hgeisse/eco32/hwtests/serial/fpga2pc/README

1. Write one of 'send0' or 'send1' to the on-board Flash ROM.
2. Load ECO32 into the FPGA.
3. While holding ECO32 in reset, start 'receive' on the PC. Choose the
   serial port according to the serial line the board is sending on.
4. Release the reset button. After a while 'receive' shows a report.
