hgeisse/eco32/libtest/abi/README

1. Register Usage
-----------------

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

caller-save registers are not preserved across procedure calls
callee-save registers are preserved across procedure calls

2. Data Type Storage Layout, Alignment, Padding
-----------------------------------------------

char         : 1 byte, no restrictions
short        : 2 bytes, aligned on 2-byte boundary
int          : 4 bytes, aligned on 4-byte boundary
long         : 4 bytes, aligned on 4-byte boundary
long long    : 4 bytes, aligned on 4-byte boundary
float        : 4 bytes, aligned on 4-byte boundary
double       : 4 bytes, aligned on 4-byte boundary
long double  : 4 bytes, aligned on 4-byte boundary
Type *       : 4 bytes, aligned on 4-byte boundary
struct       : as many bytes as needed,
               aligned for most restrictive component

3. Stack Frame Layout, Calling Conventions
------------------------------------------
