hgeisse/eco32/doc/manual/eco32.tex

\documentclass{amsbook}
\usepackage[english]{babel}
\usepackage{graphicx}
\usepackage[pdfborder={0,0,0},colorlinks=true,linkcolor=blue,urlcolor=red]{hyperref}
\begin{document}
\title{ECO32 User Manual}
\author{Martin Geisse}
\maketitle

\newcommand{\mylabel}[1]{\label{#1}}
\newcommand{\myref}[2]{\hyperref[#2]{Chapter #1, Section \ref{#2}}}

\newcommand{\definition}[1]{{\it #1}}
\newcommand{\name}[1]{{\it #1}}

\newcommand{\eco}{{\sc ECO32} }
\newcommand{\ecox}{{\sc ECO32}}
\newcommand{\pc}{{\sc PC} }
\newcommand{\pcx}{{\sc PC}}
\newcommand{\psw}{{\sc PSW} }
\newcommand{\pswx}{{\sc PSW}}
\newcommand{\mmu}{{\sc MMU} }
\newcommand{\mmux}{{\sc MMU}}

\tableofcontents
\input{intro}
\input{architecture}
\input{isa/isa}
\input{signals}
\input{demosoc}
\input{ownsoc}
\input{toolchain}
\input{impl}
\input{mybib}

\end{document}
