hgeisse/eco32/fpga/experiments/de2-115/pipectrl/README

This experiment explores a very simple 5-stage
pipeline together with its control signals.
