hgeisse/eco32/fpga/experiments/de2-115/memdelay/README

This circuit implements a RAM simulation with adjustable
read/write delays. The test FSM allows verifying both
access times.
