hgeisse/eco32/fpga/tests/test_101/README

Note: This test may run for a long time (e.g., 50 minutes) and it
may produce a large dump file (e.g., 12 GB).
