hgeisse/eco32/fpga/experiments/sim/dac/README

Timing Parameters
-----------------

clk = 50 MHz (20 nsec)
mclk = clk / 4 = 12.5 MHz (80 nsec)
bclk = mclk / 4 = 3.125 MHz (320 nsec)
lrck = bclk / 64 = 48.828 kHz (20.48 usec)

==>

fs = 48.828 kHz
mclk = 256 * fs = 12.5 MHz
bclk = 64 * fs = 3.125 MHz
