hgeisse/eco32/fpga/experiments/de2-115/memctrl-128/README

Here you can find SDRAM memory controllers
with a 128-bit host interface.
