hgeisse/eco32/fpga/experiments/de2-115/memctrl-32/README

Here you can find SDRAM memory controllers
with a 32-bit host interface.
