hgeisse/eco32/fpga/experiments/xsa-xst-3/memctrl-64/README

Here you can find SDRAM memory controllers
with a 64-bit host interface.
