hgeisse/eco32/fpga/mc/src/sdc/sdc.v

//
// sdc.v -- SD card interface
//


`timescale 1ns/10ps
`default_nettype none


//
// These constants define the two SCLK frequencies:
// f = 25 MHz / (n + 1)
//
`define FAST_WAIT	6'd0
`define SLOW_WAIT	6'd63


module sdc(clk, rst,
           stb, we, addr,
           data_in, data_out,
           ack,
           ss_n, sclk,
           mosi, miso,
           wp);
    // internal interface
    input clk;
    input rst;
    input stb;
    input we;
    input [3:2] addr;
    input [31:0] data_in;
    output [31:0] data_out;
    output ack;
    // external interface
    output reg ss_n;
    output reg sclk;
    output mosi;
    input miso;
    input wp;

  reg [8:0] sreg;
  wire load;
  wire shift;
  wire latch;
  wire ready;

  reg [4:0] state;
  reg [5:0] wtcnt;
  wire [5:0] wtnum;

  reg crc16_miso;
  reg fast_clock;
  reg rdy;

  wire crc7_in;
  reg [7:0] crc7;
  wire crc16_in;
  reg [15:0] crc16;

  always @(posedge clk) begin
    if (rst) begin
      sreg[8:0] <= 9'h1FF;
    end else begin
      if (load) begin
        sreg[8:1] <= data_in[7:0];
      end else begin
        if (shift) begin
          sreg[8:1] <= sreg[7:0];
        end
        if (latch) begin
          sreg[0] <= miso;
        end
      end
    end
  end

  assign mosi = sreg[8];

  assign wtnum[5:0] = fast_clock ? `FAST_WAIT : `SLOW_WAIT;

  always @(posedge clk) begin
    if (rst) begin
      sclk  <= 0;
      wtcnt[5:0] <= 6'd0;
      state[4:0] <= 5'd0;
    end else begin
      if (| wtcnt[5:0]) begin
        wtcnt[5:0] <= wtcnt[5:0] - 6'd1;
      end else begin
        case (state[4:0])
          5'd0:
            begin
              if (~load) begin
                state <= 5'd0;
              end else begin
                state <= 5'd1;
                wtcnt <= wtnum;
              end
            end
          5'd1:
            begin
              sclk  <= 1;
              state <= 5'd2;
              wtcnt <= wtnum;
            end
          5'd2:
            begin
              sclk  <= 0;
              state <= 5'd3;
              wtcnt <= wtnum;
            end
          5'd3:
            begin
              sclk  <= 1;
              state <= 5'd4;
              wtcnt <= wtnum;
            end
          5'd4:
            begin
              sclk  <= 0;
              state <= 5'd5;
              wtcnt <= wtnum;
            end
          5'd5:
            begin
              sclk  <= 1;
              state <= 5'd6;
              wtcnt <= wtnum;
            end
          5'd6:
            begin
              sclk  <= 0;
              state <= 5'd7;
              wtcnt <= wtnum;
            end
          5'd7:
            begin
              sclk  <= 1;
              state <= 5'd8;
              wtcnt <= wtnum;
            end
          5'd8:
            begin
              sclk  <= 0;
              state <= 5'd9;
              wtcnt <= wtnum;
            end
          5'd9:
            begin
              sclk  <= 1;
              state <= 5'd10;
              wtcnt <= wtnum;
            end
          5'd10:
            begin
              sclk  <= 0;
              state <= 5'd11;
              wtcnt <= wtnum;
            end
          5'd11:
            begin
              sclk  <= 1;
              state <= 5'd12;
              wtcnt <= wtnum;
            end
          5'd12:
            begin
              sclk  <= 0;
              state <= 5'd13;
              wtcnt <= wtnum;
            end
          5'd13:
            begin
              sclk  <= 1;
              state <= 5'd14;
              wtcnt <= wtnum;
            end
          5'd14:
            begin
              sclk  <= 0;
              state <= 5'd15;
              wtcnt <= wtnum;
            end
          5'd15:
            begin
              sclk  <= 1;
              state <= 5'd16;
              wtcnt <= wtnum;
            end
          5'd16:
            begin
              sclk  <= 0;
              state <= 5'd17;
              wtcnt <= wtnum;
            end
          5'd17:
            begin
              sclk  <= 0;
              state <= 5'd0;
              wtcnt <= 0;
            end
          default:
            begin
              sclk  <= 0;
              state <= 5'd0;
              wtcnt <= wtnum;
            end
        endcase
      end
    end
  end

  assign load = stb & we & ~addr[3] & addr[2];
  assign shift =
    (state ==  2 || state ==  4 ||
     state ==  6 || state ==  8 ||
     state == 10 || state == 12 ||
     state == 14 || state == 16) &&
    (wtcnt == 0);
  assign latch =
    (state ==  1 || state ==  3 ||
     state ==  5 || state ==  7 ||
     state ==  9 || state == 11 ||
     state == 13 || state == 15) &&
    (wtcnt == 0);
  assign ready = (state == 17) && (wtcnt == 0);

  always @(posedge clk) begin
    if (rst) begin
      crc16_miso <= 0;
      fast_clock <= 0;
      ss_n <= 1;
    end else begin
      if (stb & we & ~addr[3] & ~addr[2]) begin
        crc16_miso <= data_in[2];
        fast_clock <= data_in[1];
        ss_n <= ~data_in[0];
      end
    end
  end

  always @(posedge clk) begin
    if (rst) begin
      rdy <= 0;
    end else begin
      if (ready | (stb & ~we & ~addr[3] & addr[2])) begin
        rdy <= ready;
      end
    end
  end

  assign data_out[31:0] =
    (~addr[3] & ~addr[2]) ? { 30'h0, wp, rdy } :
    (~addr[3] &  addr[2]) ? { 24'h0, sreg[8:1] } :
    ( addr[3] & ~addr[2]) ? { 24'h0, crc7[7:0] } :
                            { 16'h0, crc16[15:0] };
  assign ack = stb;

  assign crc7_in = mosi;

  always @(posedge clk) begin
    if (rst) begin
      crc7[7:0] <= 8'h0;
    end else begin
      if (stb & we & addr[3] & ~addr[2]) begin
        crc7[7:0] <= data_in[7:0];
      end else begin
        if (latch) begin
          crc7[7] <= crc7[6];
          crc7[6] <= crc7[5];
          crc7[5] <= crc7[4];
          crc7[4] <= crc7[3] ^ crc7[7] ^ crc7_in;
          crc7[3] <= crc7[2];
          crc7[2] <= crc7[1];
          crc7[1] <= crc7[7] ^ crc7_in;
        end
      end
    end
  end

  assign crc16_in = crc16_miso ? miso : mosi;

  always @(posedge clk) begin
    if (rst) begin
      crc16[15:0] <= 16'h0;
    end else begin
      if (stb & we & addr[3] & addr[2]) begin
        crc16[15:0] <= data_in[15:0];
      end else begin
        if (latch) begin
          crc16[15] <= crc16[14];
          crc16[14] <= crc16[13];
          crc16[13] <= crc16[12];
          crc16[12] <= crc16[11] ^ crc16[15] ^ crc16_in;
          crc16[11] <= crc16[10];
          crc16[10] <= crc16[ 9];
          crc16[ 9] <= crc16[ 8];
          crc16[ 8] <= crc16[ 7];
          crc16[ 7] <= crc16[ 6];
          crc16[ 6] <= crc16[ 5];
          crc16[ 5] <= crc16[ 4] ^ crc16[15] ^ crc16_in;
          crc16[ 4] <= crc16[ 3];
          crc16[ 3] <= crc16[ 2];
          crc16[ 2] <= crc16[ 1];
          crc16[ 1] <= crc16[ 0];
          crc16[ 0] <= crc16[15] ^ crc16_in;
        end
      end
    end
  end

endmodule
