hgeisse/eco32/fpga/mc/src/kbd/kbd.v

//
// kbd.v -- PS/2 keyboard interface
//


`timescale 1ns/10ps
`default_nettype none


module kbd(clk, rst,
           stb, we, addr,
           data_in, data_out,
           ack, irq,
           ps2_clk, ps2_data);
    // internal interface
    input clk;
    input rst;
    input stb;
    input we;
    input addr;
    input [7:0] data_in;
    output [7:0] data_out;
    output ack;
    output irq;
    // external interface
    input ps2_clk;
    input ps2_data;

  wire [7:0] keyboard_data;
  wire keyboard_rdy;
  reg [7:0] data;
  reg rdy;
  reg ien;

  keyboard keyboard_1(
    .ps2_clk(ps2_clk),
    .ps2_data(ps2_data),
    .clk(clk),
    .rst(rst),
    .keyboard_data(keyboard_data[7:0]),
    .keyboard_rdy(keyboard_rdy)
  );

  always @(posedge clk) begin
    if (rst) begin
      data[7:0] <= 8'h00;
      rdy <= 1'b0;
      ien <= 1'b0;
    end else begin
      if (keyboard_rdy) begin
        data[7:0] <= keyboard_data[7:0];
      end
      if (keyboard_rdy | (stb & ~we & addr)) begin
        rdy <= keyboard_rdy;
      end
      if (stb & we & ~addr) begin
        ien <= data_in[1];
      end
    end
  end

  assign data_out[7:0] = ~addr ? { 6'h00, ien, rdy } : data[7:0];
  assign ack = stb;
  assign irq = ien & rdy;

endmodule
