hgeisse/eco32/fpga/pl-sim/eco32test.cfg

[*]
[*] GTKWave Analyzer v3.3.86 (w)1999-2017 BSI
[*] Thu Nov 29 08:52:59 2018
[*]
[dumpfile] "/home/hellwig/GitHub/eco32/fpga/pl-sim/dump.vcd"
[dumpfile_mtime] "Thu Nov 29 08:51:08 2018"
[dumpfile_size] 3534568
[savefile] "/home/hellwig/GitHub/eco32/fpga/pl-sim/eco32test.cfg"
[timestart] 0
[size] 1213 745
[pos] -1 -1
*-15.000000 -1 -1 -1 -1 -1 -1 -1 -1 -1 -1 -1 -1 -1 -1 -1 -1 -1 -1 -1 -1 -1 -1 -1 -1 -1 -1 -1
[treeopen] eco32test.
[treeopen] eco32test.eco32_1.
[treeopen] eco32test.eco32_1.cpu_1.
[treeopen] eco32test.eco32_1.cpu_1.if2_1.
[treeopen] eco32test.eco32_1.ramctrl_1.
[treeopen] eco32test.eco32_1.romctrl_1.
[sst_width] 223
[signals_width] 206
[sst_expanded] 1
[sst_vpaned_height] 321
@200
----   CLK_RST   ---
@28
eco32test.eco32_1.clk
eco32test.eco32_1.rst
@200
----     CPU     ---
-IF1a
@28
eco32test.eco32_1.cpu_1.if1a_1.if1a_ready_in
@22
eco32test.eco32_1.cpu_1.if1a_1.holdoff[7:0]
@28
eco32test.eco32_1.cpu_1.if1a_1.holdoff_counting
@22
eco32test.eco32_1.cpu_1.if1a_1.distance[3:0]
@28
eco32test.eco32_1.cpu_1.if1a_1.distance_restart
eco32test.eco32_1.cpu_1.if1a_1.if1a_valid_out
@22
eco32test.eco32_1.cpu_1.if1a_1.if1a_counter_out[9:0]
@200
-IF1b
@28
eco32test.eco32_1.cpu_1.if1b_1.if1b_ready_out
eco32test.eco32_1.cpu_1.if1b_1.if1b_valid_in
@22
eco32test.eco32_1.cpu_1.if1b_1.if1b_counter_in[9:0]
@28
eco32test.eco32_1.cpu_1.if1b_1.if1b_ready_in
eco32test.eco32_1.cpu_1.if1b_1.if1b_valid_out
@22
eco32test.eco32_1.cpu_1.if1b_1.if1b_vaddr_out[31:0]
@200
-IF2
@28
eco32test.eco32_1.cpu_1.if2_1.if2_ready_out
eco32test.eco32_1.cpu_1.if2_1.if2_valid_in
@22
eco32test.eco32_1.cpu_1.if2_1.if2_vaddr_in[31:0]
eco32test.eco32_1.cpu_1.if2_1.page[19:0]
eco32test.eco32_1.cpu_1.if2_1.offset[11:0]
eco32test.eco32_1.cpu_1.if2_1.page_buf[19:0]
eco32test.eco32_1.cpu_1.if2_1.offset_buf[11:0]
@200
----
@22
eco32test.eco32_1.cpu_1.if2_1.tlb_1.page_in[19:0]
@28
eco32test.eco32_1.cpu_1.if2_1.tlb_1.miss
@22
eco32test.eco32_1.cpu_1.if2_1.tlb_1.found[4:0]
eco32test.eco32_1.cpu_1.if2_1.tlb_1.frame_out[19:0]
@200
----
@22
eco32test.eco32_1.cpu_1.if2_1.mapped_frame[17:0]
eco32test.eco32_1.cpu_1.if2_1.direct_frame[17:0]
eco32test.eco32_1.cpu_1.if2_1.frame[17:0]
@28
eco32test.eco32_1.cpu_1.if2_1.if2_ready_in
eco32test.eco32_1.cpu_1.if2_1.if2_valid_out
@22
eco32test.eco32_1.cpu_1.if2_1.if2_paddr_out[29:0]
@200
-IF3
@28
eco32test.eco32_1.cpu_1.if3_1.if3_ready_in
eco32test.eco32_1.cpu_1.if3_1.if3_ready_out
eco32test.eco32_1.cpu_1.if3_1.if3_valid_in
eco32test.eco32_1.cpu_1.if3_1.valid_buf
eco32test.eco32_1.cpu_1.if3_1.if3_valid_out
@22
eco32test.eco32_1.cpu_1.if3_1.if3_paddr_in[29:0]
eco32test.eco32_1.cpu_1.if3_1.tag[16:0]
eco32test.eco32_1.cpu_1.if3_1.index[8:0]
@28
eco32test.eco32_1.cpu_1.if3_1.offset[1:0]
@22
eco32test.eco32_1.cpu_1.if3_1.tag_buf[16:0]
eco32test.eco32_1.cpu_1.if3_1.index_buf[8:0]
@28
eco32test.eco32_1.cpu_1.if3_1.offset_buf[1:0]
eco32test.eco32_1.cpu_1.if3_1.sel_index[1:0]
@22
eco32test.eco32_1.cpu_1.if3_1.cur_index[8:0]
@28
eco32test.eco32_1.cpu_1.if3_1.line_0_valid_out
@22
eco32test.eco32_1.cpu_1.if3_1.line_0_tag_out[16:0]
eco32test.eco32_1.cpu_1.if3_1.line_0_data_out[127:0]
@28
eco32test.eco32_1.cpu_1.if3_1.line_0_hit
eco32test.eco32_1.cpu_1.if3_1.line_1_valid_out
@22
eco32test.eco32_1.cpu_1.if3_1.line_1_tag_out[16:0]
eco32test.eco32_1.cpu_1.if3_1.line_1_data_out[127:0]
@28
eco32test.eco32_1.cpu_1.if3_1.line_1_hit
@22
eco32test.eco32_1.cpu_1.if3_1.line_data_out[127:0]
eco32test.eco32_1.cpu_1.if3_1.if3_inst_out[31:0]
@28
eco32test.eco32_1.cpu_1.if3_1.hit
eco32test.eco32_1.cpu_1.if3_1.lru_out
eco32test.eco32_1.cpu_1.if3_1.memory_ack
eco32test.eco32_1.cpu_1.if3_1.memory_ack_buf
@22
eco32test.eco32_1.cpu_1.if3_1.index_count[9:0]
@28
eco32test.eco32_1.cpu_1.if3_1.invalidate
@200
-TEST
@28
eco32test.eco32_1.cpu_1.test_1.test_ready_out
eco32test.eco32_1.cpu_1.test_1.test_valid_in
@22
eco32test.eco32_1.cpu_1.test_1.test_data_in[31:0]
@28
eco32test.eco32_1.cpu_1.test_1.sel[1:0]
@22
eco32test.eco32_1.cpu_1.test_1.byte[7:0]
eco32test.eco32_1.cpu_1.test_1.ctrl[7:0]
eco32test.eco32_1.cpu_1.test_1.crctbl_out[31:0]
eco32test.eco32_1.cpu_1.test_1.crc32_new[31:0]
@28
eco32test.eco32_1.cpu_1.test_1.crc32_we
@22
eco32test.eco32_1.cpu_1.test_1.crc32[31:0]
@28
eco32test.eco32_1.cpu_1.test_1.state[2:0]
eco32test.eco32_1.cpu_1.test_1.word_done
@22
eco32test.eco32_1.cpu_1.test_1.count[11:0]
@200
---- Indicators  ---
@28
eco32test.eco32_1.test_step
eco32test.eco32_1.test_good
eco32test.eco32_1.test_ended
eco32test.eco32_1.any_step_failed
eco32test.eco32_1.test_end_seen
@22
eco32test.eco32_1.first_fail[7:0]
@28
eco32test.eco32_1.led_g
eco32test.eco32_1.led_r
@200
----   RAMCTRL   ---
-RAM
----   ROMCTRL   ---
@28
eco32test.eco32_1.romctrl_1.inst_stb
@22
eco32test.eco32_1.romctrl_1.inst_addr[23:0]
@28
eco32test.eco32_1.romctrl_1.data_stb
@22
eco32test.eco32_1.romctrl_1.data_addr[23:0]
@28
eco32test.eco32_1.romctrl_1.state[2:0]
eco32test.eco32_1.romctrl_1.rom_as
eco32test.eco32_1.romctrl_1.rom_la_clr
eco32test.eco32_1.romctrl_1.rom_la_inc
@22
eco32test.eco32_1.romctrl_1.rom_la[3:0]
@28
eco32test.eco32_1.romctrl_1.data_wr
@22
eco32test.eco32_1.romctrl_1.inst_dout[127:0]
@28
eco32test.eco32_1.romctrl_1.inst_ack
@22
eco32test.eco32_1.romctrl_1.data_dout[127:0]
@28
eco32test.eco32_1.romctrl_1.data_ack
@200
-ROM
@28
eco32test.eco32_1.romctrl_1.rom1.stb
@22
eco32test.eco32_1.romctrl_1.rom1.addr[22:0]
eco32test.eco32_1.romctrl_1.rom1.counter[3:0]
eco32test.eco32_1.romctrl_1.rom1.data_out[7:0]
@28
eco32test.eco32_1.romctrl_1.rom1.ack
[pattern_trace] 1
[pattern_trace] 0
