hgeisse/eco32/fpga/experiments/sim/ps2/ps2comm.cfg

[*]
[*] GTKWave Analyzer v3.3.86 (w)1999-2017 BSI
[*] Tue Mar 24 10:01:06 2020
[*]
[dumpfile] "/home/hellwig/GitHub/eco32-oberon/eco32/fpga/experiments/sim/ps2/dump.vcd"
[dumpfile_mtime] "Tue Mar 24 09:59:33 2020"
[dumpfile_size] 14857278
[savefile] "/home/hellwig/GitHub/eco32-oberon/eco32/fpga/experiments/sim/ps2/ps2comm.cfg"
[timestart] 0
[size] 1213 745
[pos] -1 -1
*-28.000000 0 -1 -1 -1 -1 -1 -1 -1 -1 -1 -1 -1 -1 -1 -1 -1 -1 -1 -1 -1 -1 -1 -1 -1 -1 -1 -1
[treeopen] ps2comm.
[sst_width] 223
[signals_width] 190
[sst_expanded] 1
[sst_vpaned_height] 203
@28
ps2comm.clk
ps2comm.rst
ps2comm.ps2_clock
ps2comm.ps2_data
@200
---- DEVICE ---
-rcv
@28
ps2comm.device_0.ps2_clk_s
ps2comm.device_0.ps2_dat_s
@22
ps2comm.device_0.ps2_clk_int[3:0]
ps2comm.device_0.ps2_dat_int[3:0]
@28
ps2comm.device_0.ps2_clk_lvl
ps2comm.device_0.ps2_dat_lvl
@22
ps2comm.device_0.rcv_data[7:0]
@28
ps2comm.device_0.rcv_error
ps2comm.device_0.rcv_strobe
@200
-fsm
@22
ps2comm.device_0.sr[10:0]
@28
ps2comm.device_0.sr_load
ps2comm.device_0.sr_shift
@22
ps2comm.device_0.bc[3:0]
@28
ps2comm.device_0.bc_clear
ps2comm.device_0.clk_quiet
@22
ps2comm.device_0.tmr20[9:0]
@28
ps2comm.device_0.tmr20_run
ps2comm.device_0.tmr20_exp
ps2comm.device_0.state[3:0]
@200
-xmt
@28
ps2comm.device_0.xmt_ready
@22
ps2comm.device_0.xmt_data[7:0]
@28
ps2comm.device_0.xmt_strobe
ps2comm.device_0.ps2_clk_out
ps2comm.device_0.ps2_dat_out
@200
---- HOST ---
-rcv
@28
ps2comm.host_0.ps2_clk_s
ps2comm.host_0.ps2_dat_s
@22
ps2comm.host_0.ps2_clk_int[3:0]
ps2comm.host_0.ps2_dat_int[3:0]
@28
ps2comm.host_0.ps2_clk_lvl
ps2comm.host_0.ps2_dat_lvl
@22
ps2comm.host_0.rcv_data[7:0]
@28
ps2comm.host_0.rcv_error
ps2comm.host_0.rcv_strobe
@200
-fsm
@22
ps2comm.host_0.sr[10:0]
@28
ps2comm.host_0.sr_load
ps2comm.host_0.sr_shift
@22
ps2comm.host_0.bc[3:0]
@28
ps2comm.host_0.bc_clear
ps2comm.host_0.clk_quiet
ps2comm.host_0.clk_inhib
ps2comm.host_0.state[2:0]
@200
-xmt
@28
ps2comm.host_0.xmt_ready
@22
ps2comm.host_0.xmt_data[7:0]
@28
ps2comm.host_0.xmt_strobe
ps2comm.host_0.ps2_clk_out
ps2comm.host_0.ps2_dat_out
[pattern_trace] 1
[pattern_trace] 0
