hgeisse/eco32/fpga/experiments/sim/dac/dac_test.cfg

[*]
[*] GTKWave Analyzer v3.3.66 (w)1999-2015 BSI
[*] Tue Sep 29 09:04:19 2020
[*]
[dumpfile] "/home/hellwig/GitHub/eco32/fpga/experiments/sim/dac/dump.vcd"
[dumpfile_mtime] "Tue Sep 29 09:04:05 2020"
[dumpfile_size] 192751
[savefile] "/home/hellwig/GitHub/eco32/fpga/experiments/sim/dac/dac_test.cfg"
[timestart] 0
[size] 1215 776
[pos] 290 -124
*-16.705465 0 -1 -1 -1 -1 -1 -1 -1 -1 -1 -1 -1 -1 -1 -1 -1 -1 -1 -1 -1 -1 -1 -1 -1 -1 -1 -1
[treeopen] dac_test.
[sst_width] 43
[signals_width] 142
[sst_expanded] 0
[sst_vpaned_height] 160
@28
dac_test.dac_1.clk
dac_test.dac_1.rst
@22
dac_test.dac_1.sample_l[23:0]
dac_test.dac_1.sample_r[23:0]
dac_test.dac_1.timing[9:0]
dac_test.dac_1.sr[63:0]
@28
dac_test.dac_1.shift
dac_test.dac_1.next
dac_test.dac_1.mclk
dac_test.dac_1.bclk
dac_test.dac_1.lrck
dac_test.dac_1.sdti
[pattern_trace] 1
[pattern_trace] 0
