hgeisse/eco32/fpga/experiments/sim/i2c/i2c_tst.cfg

[*]
[*] GTKWave Analyzer v3.3.66 (w)1999-2015 BSI
[*] Sun Sep 20 10:34:04 2020
[*]
[dumpfile] "/home/hellwig/I2C/sim/dump.vcd"
[dumpfile_mtime] "Sun Sep 20 10:32:29 2020"
[dumpfile_size] 166742
[savefile] "/home/hellwig/I2C/sim/i2c_tst.cfg"
[timestart] 0
[size] 1855 1056
[pos] -1 -1
*-19.000000 -1 -1 -1 -1 -1 -1 -1 -1 -1 -1 -1 -1 -1 -1 -1 -1 -1 -1 -1 -1 -1 -1 -1 -1 -1 -1 -1
[treeopen] i2c_tst.
[treeopen] i2c_tst.i2c_mc_0.
[treeopen] i2c_tst.i2c_mc_0.i2c_byte_0.
[treeopen] i2c_tst.i2c_mc_0.i2c_byte_0.i2c_bit_0.
[sst_width] 225
[signals_width] 158
[sst_expanded] 1
[sst_vpaned_height] 320
@28
i2c_tst.clk
i2c_tst.rst
@200
---- I2C_MC ---
@22
i2c_tst.i2c_mc_0.data[15:0]
@28
i2c_tst.i2c_mc_0.start
@22
i2c_tst.i2c_mc_0.state[3:0]
@28
i2c_tst.i2c_mc_0.done
i2c_tst.i2c_mc_0.error
@200
---- BYTE ---
@28
i2c_tst.i2c_mc_0.i2c_byte_0.byte_fnc[1:0]
@22
i2c_tst.i2c_mc_0.i2c_byte_0.byte_data[7:0]
@28
i2c_tst.i2c_mc_0.i2c_byte_0.byte_start
@24
i2c_tst.i2c_mc_0.i2c_byte_0.bitcnt[2:0]
@28
i2c_tst.i2c_mc_0.i2c_byte_0.bitcnt_start
i2c_tst.i2c_mc_0.i2c_byte_0.bitcnt_count
i2c_tst.i2c_mc_0.i2c_byte_0.bitcnt_done
@24
i2c_tst.i2c_mc_0.i2c_byte_0.state[2:0]
@28
i2c_tst.i2c_mc_0.i2c_byte_0.byte_done
i2c_tst.i2c_mc_0.i2c_byte_0.byte_error
@200
---- BIT ---
@28
i2c_tst.i2c_mc_0.i2c_byte_0.i2c_bit_0.bit_fnc[1:0]
i2c_tst.i2c_mc_0.i2c_byte_0.i2c_bit_0.bit_start
@24
i2c_tst.i2c_mc_0.i2c_byte_0.i2c_bit_0.clkcnt[5:0]
@28
i2c_tst.i2c_mc_0.i2c_byte_0.i2c_bit_0.clkcnt_start
i2c_tst.i2c_mc_0.i2c_byte_0.i2c_bit_0.clkcnt_done
i2c_tst.i2c_mc_0.i2c_byte_0.i2c_bit_0.clkcnt_center
@22
i2c_tst.i2c_mc_0.i2c_byte_0.i2c_bit_0.state[3:0]
@28
i2c_tst.i2c_mc_0.i2c_byte_0.i2c_bit_0.bit_done
i2c_tst.i2c_mc_0.i2c_byte_0.i2c_bit_0.bit_rcv
@200
---- PHY ---
@28
i2c_tst.i2c_mc_0.i2c_byte_0.i2c_bit_0.i2c_phy_0.scl_snd
i2c_tst.i2c_mc_0.i2c_byte_0.i2c_bit_0.i2c_phy_0.sda_snd
i2c_tst.i2c_mc_0.i2c_byte_0.i2c_bit_0.i2c_phy_0.sda_rcv
@200
---- LINE ---
@28
i2c_tst.i2c_mc_0.i2c_byte_0.i2c_bit_0.i2c_phy_0.i2c_scl
i2c_tst.i2c_mc_0.i2c_byte_0.i2c_bit_0.i2c_phy_0.i2c_sda
@200
---- ACK ---
@28
i2c_tst.ack_gen_0.ack
[pattern_trace] 1
[pattern_trace] 0
