hgeisse/eco32/fpga/mc/boards/s3e-500/doc/dac/dac_test.cfg

[timestart] 41060000
[size] 1023 693
[pos] -1 -1
*-16.000000 41100000 -1 -1 -1 -1 -1 -1 -1 -1 -1 -1 -1 -1 -1 -1 -1 -1 -1 -1 -1 -1 -1 -1 -1 -1 -1 -1
@28
dac_test.clk
dac_test.reset
@22
dac_test.sample_l[15:0]
dac_test.sample_r[15:0]
dac_test.dac_1.timing[9:0]
dac_test.dac_1.sr[47:0]
@28
dac_test.dac_1.shift
dac_test.next
dac_test.sck
dac_test.sdi
dac_test.ld
