hgeisse/eco32/sim/command.c

/*
 * command.c -- command interpreter
 */


#include <stdio.h>
#include <stdlib.h>
#include <string.h>
#include <setjmp.h>

#include "common.h"
#include "console.h"
#include "error.h"
#include "except.h"
#include "command.h"
#include "asm.h"
#include "disasm.h"
#include "cpu.h"
#include "trace.h"
#include "mmu.h"
#include "icache.h"
#include "dcache.h"
#include "ram.h"
#include "rom.h"
#include "io.h"
#include "timer.h"
#include "dsp.h"
#include "kbd.h"
#include "serial.h"
#include "disk.h"
#include "sdcard.h"
#include "bio.h"
#include "output.h"
#include "shutdown.h"
#include "graph1.h"
#include "graph2.h"
#include "mouse.h"


#define MAX_TOKENS	10


static Bool quit;


typedef struct {
  char *name;
  void (*hlpProc)(void);
  void (*cmdProc)(char *tokens[], int n);
} Command;

extern Command commands[];
extern int numCommands;


static void help(void) {
  cPrintf("valid commands are:\n");
  cPrintf("  help    get help\n");
  cPrintf("  +       add and subtract\n");
  cPrintf("  a       assemble\n");
  cPrintf("  u       unassemble\n");
  cPrintf("  b       set/reset breakpoint\n");
  cPrintf("  c       continue from breakpoint\n");
  cPrintf("  s       single-step\n");
  cPrintf("  #       show/set PC\n");
  cPrintf("  p       show/set PSW\n");
  cPrintf("  r       show/set register\n");
  cPrintf("  d       dump memory\n");
  cPrintf("  mw      show/set memory word\n");
  cPrintf("  mh      show/set memory halfword\n");
  cPrintf("  mb      show/set memory byte\n");
  cPrintf("  t       show/set TLB contents\n");
  cPrintf("  l       list trace buffer\n");
  cPrintf("  i       initialize hardware\n");
  cPrintf("  ic      instr cache control\n");
  cPrintf("  dc      data cache control\n");
  cPrintf("  pm      show physical memory\n");
  cPrintf("  sb      show/set board I/O\n");
  cPrintf("  q       quit simulator\n");
  cPrintf("type 'help <cmd>' to get help for <cmd>\n");
}


static void help00(void) {
  cPrintf("  help              show a list of commands\n");
  cPrintf("  help <cmd>        show help for <cmd>\n");
}


static void help01(void) {
  cPrintf("  +  <num1> <num2>  add and subtract <num1> and <num2>\n");
}


static void help02(void) {
  cPrintf("  a                 assemble starting at PC\n");
  cPrintf("  a  <addr>         assemble starting at <addr>\n");
}


static void help03(void) {
  cPrintf("  u                 unassemble 16 instrs starting at PC\n");
  cPrintf("  u  <addr>         unassemble 16 instrs starting at <addr>\n");
  cPrintf("  u  <addr> <cnt>   unassemble <cnt> instrs starting at <addr>\n");
}


static void help04(void) {
  cPrintf("  b                 reset break\n");
  cPrintf("  b  <addr>         set break at <addr>\n");
}


static void help05(void) {
  cPrintf("  c                 continue execution\n");
  cPrintf("  c  <cnt>          continue execution <cnt> times\n");
}


static void help06(void) {
  cPrintf("  s                 single-step one instruction\n");
  cPrintf("  s  <cnt>          single-step <cnt> instructions\n");
}


static void help07(void) {
  cPrintf("  #                 show PC\n");
  cPrintf("  #  <addr>         set PC to <addr>\n");
}


static void help08(void) {
  cPrintf("  p                 show PSW\n");
  cPrintf("  p  <data>         set PSW to <data>\n");
}


static void help09(void) {
  cPrintf("  r                 show all registers\n");
  cPrintf("  r  <reg>          show register <reg>\n");
  cPrintf("  r  <reg> <data>   set register <reg> to <data>\n");
}


static void help10(void) {
  cPrintf("  d                 dump 256 bytes starting at PC\n");
  cPrintf("  d  <addr>         dump 256 bytes starting at <addr>\n");
  cPrintf("  d  <addr> <cnt>   dump <cnt> bytes starting at <addr>\n");
}


static void help11(void) {
  cPrintf("  mw                show memory word at PC\n");
  cPrintf("  mw <addr>         show memory word at <addr>\n");
  cPrintf("  mw <addr> <data>  set memory word at <addr> to <data>\n");
}


static void help12(void) {
  cPrintf("  mh                show memory halfword at PC\n");
  cPrintf("  mh <addr>         show memory halfword at <addr>\n");
  cPrintf("  mh <addr> <data>  set memory halfword at <addr> to <data>\n");
}


static void help13(void) {
  cPrintf("  mb                show memory byte at PC\n");
  cPrintf("  mb <addr>         show memory byte at <addr>\n");
  cPrintf("  mb <addr> <data>  set memory byte at <addr> to <data>\n");
}


static void help14(void) {
  cPrintf("  t                 show TLB contents\n");
  cPrintf("  t  <i>            show TLB contents at <i>\n");
  cPrintf("  t  <i> p <data>   set TLB contents at <i> to page <data>\n");
  cPrintf("  t  <i> f <data>   set TLB contents at <i> to frame <data>\n");
}


static void help15(void) {
  cPrintf("  l                 list 16 trace entries starting at -16\n");
  cPrintf("  l <i>             list 16 trace entries starting at <i>\n");
  cPrintf("  l <i> <cnt>       list <cnt> trace entries starting at <i>\n");
}


static void help16(void) {
  cPrintf("  i                 initialize hardware\n");
}


static void help17(void) {
  cPrintf("  ic i              invalidate instr cache\n");
  cPrintf("  ic s              show instr cache statistics\n");
  cPrintf("  ic r              reset instr cache\n");
}


static void help18(void) {
  cPrintf("  dc f              flush data cache\n");
  cPrintf("  dc i              invalidate data cache\n");
  cPrintf("  dc s              show data cache statistics\n");
  cPrintf("  dc r              reset data cache\n");
}


static void help19(void) {
  cPrintf("  pm <paddr>        show 16 words of phys mem at <paddr>\n");
  cPrintf("  pm <paddr> <cnt>  show <cnt> words of phys mem at <paddr>\n");
}


static void help20(void) {
  cPrintf("  sb                show board LEDs, switches, and buttons\n");
  cPrintf("  sb <3 hex>        set buttons (1 hex) and switches (2 hex)\n");
}


static void help21(void) {
  cPrintf("  q                 quit simulator\n");
}


static void syncCaches(void) {
  icacheInvalidate();
  dcacheFlush();
}


static Bool getHexNumber(char *str, Word *valptr) {
  char *end;

  *valptr = strtoul(str, &end, 16);
  return *end == '\0';
}


static Bool getDecNumber(char *str, int *valptr) {
  char *end;

  *valptr = strtoul(str, &end, 10);
  return *end == '\0';
}


static void showPC(void) {
  Word pc, psw;
  Word instr;

  pc = cpuGetPC();
  psw = cpuGetPSW();
  instr = mmuReadWord(pc, psw & PSW_UM);
  cPrintf("PC   %08X     [PC]   %08X   %s\n",
          pc, instr, disasm(instr, pc));
}


static void showBreakAndTotal(void) {
  Word brk;
  Word tot;

  brk = cpuGetBreak();
  tot = cpuGetTotal();
  cPrintf("Brk  ");
  if (cpuTestBreak()) {
    cPrintf("%08X", brk);
  } else {
    cPrintf("--------");
  }
  cPrintf("     Total  %08X   instructions\n", tot);
}


static void showIRQ(void) {
  Word irq;
  int i;

  irq = cpuGetIRQ();
  cPrintf("IRQ                            ");
  for (i = 15; i >= 0; i--) {
    cPrintf("%c", irq & (1 << i) ? '1' : '0');
  }
  cPrintf("\n");
}


static void showPSW(void) {
  Word psw;
  int i;

  psw = cpuGetPSW();
  cPrintf("     xxxx  V  UPO  IPO  IACK   MASK\n");
  cPrintf("PSW  ");
  for (i = 31; i >= 0; i--) {
    if (i == 27 || i == 26 || i == 23 || i == 20 || i == 15) {
      cPrintf("  ");
    }
    cPrintf("%c", psw & (1 << i) ? '1' : '0');
  }
  cPrintf("\n");
}


static void doHelp(char *tokens[], int n) {
  int i;

  if (n == 1) {
    help();
  } else if (n == 2) {
    for (i = 0; i < numCommands; i++) {
      if (strcmp(commands[i].name, tokens[1]) == 0) {
        (*commands[i].hlpProc)();
        return;
      }
    }
    cPrintf("no help available for '%s', sorry\n", tokens[1]);
  } else {
    help00();
  }
}


static void doArith(char *tokens[], int n) {
  Word num1, num2, num3, num4;

  if (n == 3) {
    if (!getHexNumber(tokens[1], &num1)) {
      cPrintf("illegal first number\n");
      return;
    }
    if (!getHexNumber(tokens[2], &num2)) {
      cPrintf("illegal second number\n");
      return;
    }
    num3 = num1 + num2;
    num4 = num1 - num2;
    cPrintf("add = %08X, sub = %08X\n", num3, num4);
  } else {
    help01();
  }
}


static void doAssemble(char *tokens[], int n) {
  Word addr;
  Word psw;
  char prompt[30];
  char *line;
  char *msg;
  Word instr;

  if (n == 1) {
    addr = cpuGetPC();
  } else if (n == 2) {
    if (!getHexNumber(tokens[1], &addr)) {
      cPrintf("illegal address\n");
      return;
    }
  } else {
    help02();
    return;
  }
  addr &= ~0x00000003;
  psw = cpuGetPSW();
  while (1) {
    sprintf(prompt, "ASM # %08X: ", addr);
    line = cGetLine(prompt);
    if (*line == '\0' || *line == '\n') {
      break;
    }
    cAddHist(line);
    msg = asmInstr(line, addr, &instr);
    if (msg != NULL) {
      cPrintf("%s\n", msg);
    } else {
      mmuWriteWord(addr, instr, psw & PSW_UM);
      syncCaches();
      addr += 4;
    }
  }
}


static void doUnassemble(char *tokens[], int n) {
  Word addr, count;
  Word psw;
  int i;
  Word instr;

  if (n == 1) {
    addr = cpuGetPC();
    count = 16;
  } else if (n == 2) {
    if (!getHexNumber(tokens[1], &addr)) {
      cPrintf("illegal address\n");
      return;
    }
    count = 16;
  } else if (n == 3) {
    if (!getHexNumber(tokens[1], &addr)) {
      cPrintf("illegal address\n");
      return;
    }
    if (!getHexNumber(tokens[2], &count)) {
      cPrintf("illegal count\n");
      return;
    }
    if (count == 0) {
      return;
    }
  } else {
    help03();
    return;
  }
  addr &= ~0x00000003;
  psw = cpuGetPSW();
  for (i = 0; i < count; i++) {
    instr = mmuReadWord(addr, psw & PSW_UM);
    cPrintf("%08X:  %08X    %s\n",
            addr, instr, disasm(instr, addr));
    if (addr + 4 < addr) {
      /* wrap-around */
      break;
    }
    addr += 4;
  }
}


static void doBreak(char *tokens[], int n) {
  Word addr;

  if (n == 1) {
    cpuResetBreak();
    showBreakAndTotal();
  } else if (n == 2) {
    if (!getHexNumber(tokens[1], &addr)) {
      cPrintf("illegal address\n");
      return;
    }
    addr &= ~0x00000003;
    cpuSetBreak(addr);
    showBreakAndTotal();
  } else {
    help04();
  }
}


static void doContinue(char *tokens[], int n) {
  Word count, i;
  Word addr;

  if (n == 1) {
    count = 1;
  } else if (n == 2) {
    if (!getHexNumber(tokens[1], &count) || count == 0) {
      cPrintf("illegal count\n");
      return;
    }
  } else {
    help05();
    return;
  }
  cPrintf("CPU is running, press ^C to interrupt...\n");
  for (i = 0; i < count; i++) {
    cpuRun();
  }
  addr = cpuGetPC();
  cPrintf("Break at %08X\n", addr);
  showPC();
}


static void doStep(char *tokens[], int n) {
  Word count, i;

  if (n == 1) {
    count = 1;
  } else if (n == 2) {
    if (!getHexNumber(tokens[1], &count) || count == 0) {
      cPrintf("illegal count\n");
      return;
    }
  } else {
    help06();
    return;
  }
  for (i = 0; i < count; i++) {
    cpuStep();
  }
  showPC();
}


static void doPC(char *tokens[], int n) {
  Word addr;

  if (n == 1) {
    showPC();
  } else if (n == 2) {
    if (!getHexNumber(tokens[1], &addr)) {
      cPrintf("illegal address\n");
      return;
    }
    addr &= ~0x00000003;
    cpuSetPC(addr);
    showPC();
  } else {
    help07();
  }
}
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
