hgeisse/eco32/(commit log)

2014-02-04 current version is 0.22
2014-02-18 new timing model, second timer, shutdown device
2014-02-24 hardware: timer now equal to port-15
2014-02-24 hardware: timer counts clock cycles, counter is readable
2014-02-24 hardware: two timers
2014-02-28 hwtests (kbd): second timer added
2014-03-14 binutils: correct types in ar
    [ar.h]
2014-03-16 hardware: in cpu/sregs change signal names di->din, do->dout
2014-03-17 hardware: cpu external pin ordering
2014-03-17 hardware: ram pin ordering
2014-08-25 board-specific I/O module added
2014-08-25 board I/O for XSA board
2014-08-25 monitor for XESS board honors console I/O switch setting
2014-08-28 IDE interface byte-order problem solved
    [atabuf.v]
2014-09-22 integration of starter board version
2014-09-23 DAC controller added to ECO32 for XESS board
    [dac_test.cfg]
2014-09-24 DAC simulation for Digilent board
    [dac_test.cfg]
2014-09-26 README for XESS board
2014-09-28 project and bit file for Digilent board
2014-09-28 instructions for programming the Digilent board
2014-09-28 flashing the ROM on the s3e starter kit board
2014-09-29 flashing the parallel ROM on the s3e starter kit board
2014-09-29 monitor for Digilent board honors console I/O switch setting
2015-03-12 simulator 64-bit clean, corrected thread handling, alpha values in pixels
    [dspkbd.c, graph.c]
2015-03-30 simulator got trace buffer
2015-03-30 simulator: show last interrupt number in decimal
2015-08-08 new directory structure within fpga
    [dac_test.cfg]
2015-08-11 avoid timing violations in DDR RAM circuit, new .bit files generated
    [ram.v]
2015-08-14 memdelay experiment added
    [memdelay.cfg]
2015-08-14 xsa-xst-3 dac simulation corrected
    [dac_test.cfg]
2015-08-14 s3e-500 dac simulation corrected
    [dac_test.cfg]
2015-08-14 multicycle simulation control files added
    [eco32test.cfg]
2015-08-19 verilated mc implementation with and without trace
    [eco32test.cfg]
2015-08-20 memory controller simulation 0
    [memtest.cfg]
2015-08-20 memory controller simulation 1
    [memtest.cfg]
2015-08-20 memory controller simulation 2
    [memtest.cfg]
2016-09-12 lcc/lburg/gram.y: prototype for yylex() added
2017-02-14 add Terasic board DE2-115
2017-02-18 port ECO32 to DE2-115: toplevel (preliminary) and dsp
    [eco32.csv]
2017-02-21 add serial lines
    [eco32.csv]
2017-02-21 add timers
2017-02-24 convert from DOS line endings
    [eco32.csv]
2017-02-27 Flash programmer finished, CPU reset back to 0xE0000000
    [cpu_core.v]
2017-02-27 revert monitor split, part 1
    [main.c]
2017-02-27 revert monitor split, part 2
    [main.c]
2017-02-28 add board-specific I/O
2017-02-28 add machine monitor for DE2-115 board
2017-03-01 add keyboard controller
    [eco32.csv]
2017-03-03 different subdirectories for different boards in "experiments"
    [memdelay.cfg, memtest.cfg]
2017-03-03 add experiment "memdelay" for DE2-115 board
    [memdelay.cfg]
2017-03-05 add experiment "memctrl/sim/memctrl-0" for DE2-115 board
    [memtest.cfg]
2017-03-07 add experiment "memctrl/sim/memctrl-1" for DE2-115 board
    [memtest.cfg]
2017-03-10 add experiment "memctrl/fpga/memctrl-1" for DE2-115 board
    [memtest.csv]
2017-03-11 add experiment "memctrl/sim/memctrl-2" for DE2-115 board
    [memtest.cfg]
2017-03-11 correct error in phase shift calculation
    [clk_rst.v]
2017-03-11 add experiment "memctrl/fpga/memctrl-2" for DE2-115 board
    [memtest.csv]
2017-03-13 correct timimg error in SDRAM controller
    [ramctrl.v]
2017-03-13 add SDRAM main memory
    [eco32.csv]
2017-03-18 add basic SD card access
    [eco32.csv]
2017-03-20 add experiment "sdcard" for DE2-115 board
    [sdcbench.cfg]
2017-03-22 port SD card controller changes back to SD experiment
    [sdcbench.cfg]
2017-03-22 add crc7 and crc16
    [sdcbench.cfg]
2017-03-23 editorial changes
    [sdcbench.cfg]
2017-03-23 simple SD card interface using SPI
    [eco32.csv]
2017-04-04 use SD card interface in machine monitor for DE2-115 board
2017-04-25 add bit width of host interface to name
    [memtest.cfg]
2017-04-27 add first version of 128-bit SDRAM controller, simulation only
    [memtest.cfg]
2017-04-29 do no longer show the controllers's internal state
    [memtest.cfg]
2017-04-30 add second version of 128-bit SDRAM controller, more realistic simulation
    [memtest.cfg]
2017-05-01 add 128-bit SDRAM controller, to be used on the FPGA
    [memtest.csv]
2017-11-06 update lcc driver for Linux
2017-11-09 recognize 3 additional compiler driver options
2017-11-11 recognize another compiler driver option
2017-11-17 correct adding a symtable entry in case of growing the table
2017-12-16 add third version of 128-bit SDRAM controller for simulation, 50/100 MHz
    [memtest.cfg]
2017-12-17 add 128-bit SDRAM controller for FPGA, 50/100 MHz
    [memtest.csv]
2018-02-10 add pipectrl experiment
    [pipetest.cfg, pipetest.csv]
2018-02-11 add icache demo
    [democache.cfg]
2018-04-07 correct write to status words of I/O devices
    [disk.c, dspkbd.c, serial.c, timer.c]
2018-04-19 correct read status word of timer device
    [timer.c]
2018-04-20 correct stdalone progs for new behavior of I/O status registers, part1
    [main.c]
2018-04-20 correct stdalone progs for new behavior of I/O status registers, part2
    [main.c]
2018-05-08 move automatic segment padding from assembler to linker
2018-05-17 update kbd tables, throttle data stream from kbd
2018-06-25 accept -pic flag in compiler driver
2018-08-07 add asm-4: assembler support for accessing static data
2018-08-07 add asm-5: assembler support for accessing global data
2018-09-04 add main() to test pic/c-4/prog.c, set PIC flag in assembler call
2018-09-04 enable PIC in compiler driver and backend
2018-09-05 accept .ldgot pseudo-op only if cmdline switch -p is present
2018-09-21 correct write to status word of timer device
    [tmr.v]
2018-09-23 correct write to status word of keyboard device
    [kbd.v]
2018-09-25 correct write to status word of disk device
    [atactrl.v]
2018-10-03 add command line switches to configure icache/dcache associativities
2018-10-15 update tmr device
2018-10-15 update clock and reset generator
    [clk_rst.v]
2018-10-17 update dsp device
2018-10-18 update kbd device
2018-10-18 update kbd device, again
2018-10-18 update ser device
2018-10-18 show less signals in test bench
    [eco32test.cfg]
2018-10-22 rename direct-mapped icache test
    [democache.cfg]
2018-10-27 add 2-way associative demo cache, v0
    [democache.cfg]
2018-10-27 add 2-way associative demo cache, v1
    [democache.cfg]
2018-10-28 add 2-way associative demo cache, v2
    [democache.cfg]
2018-11-02 add 2-way associative demo cache, v3
    [democache.cfg]
2018-11-04 add 2-way associative demo icache, v4
    [democache.cfg]
2018-11-05 start a pipeline simulation of ECO32
    [eco32test.cfg]
2018-11-06 start a pipeline implementation of ECO32
    [eco32.csv]
2018-11-08 add instr address translation to simulation
    [eco32test.cfg]
2018-11-08 enhance test in simulation
    [eco32test.cfg]
2018-11-10 correct end-of-test handling in simulation
    [eco32test.cfg]
2018-11-10 test address translation in simulation
    [eco32test.cfg]
2018-11-18 add a test circuit for checksumming the ROM
2018-11-18 adapt simulation environment
    [eco32test.cfg]
2018-11-20 add the test circuit for checksumming the ROM
2018-11-20 adapt constraints
    [eco32.csv]
2018-11-20 remove test circuit from simulation
    [eco32test.cfg]
2018-11-20 remove test circuit from implementation
2018-11-25 add switch for output width selection to bin2dat
2018-11-26 add icache to simulation
    [eco32test.cfg]
2018-11-29 add program which computes CRC fingerprint for IF stage
2018-11-29 add test for IF pipeline stage to simulation
    [eco32test.cfg]
2018-12-01 add test for IF pipeline stage to implementation
2018-12-08 add testpattern generator tests
    [democache.cfg]
2018-12-13 add direct-mapped demo dcache, v0
    [democache.cfg]
2018-12-13 record all interesting signals
    [democache.cfg]
2018-12-17 add direct-mapped demo dcache, v1
    [democache.cfg]
2018-12-18 add direct-mapped demo dcache, v2
    [democache.cfg]
2019-01-13 enable reading a pixel from the graphics frame buffer
2019-02-09 add a framework for library tests
2020-03-27 add simulation of PS/2 communication
    [ps2comm.cfg]
2020-03-30 change signal name rcv_ready to rcv_strobe
    [ps2comm.cfg]
2020-03-31 make keyboard I/O bidirectional, add mouse I/O
    [eco32.csv]
2020-04-12 add PS/2 mouse simulation and change keyboard to true PS/2 device
2020-04-13 add mouse interrupt to all ISR tables
2020-04-13 add current output files
2020-05-03 add board I/O to simulator
2020-05-12 prevent the sim crashing on dividing MOST_NEG by -1
    [cpu.c]
2020-09-20 add I2C master controller simulation
    [i2c_tst.cfg]
2020-09-20 add I2C specification
2020-09-28 add DAC timing generator
    [dac_test.cfg]
2020-09-29 change 20 bit audio data to 24 bit
    [dac_test.cfg]
2021-11-30 Revert "delete dynlink from master branch"
    This reverts commit b1644b915c6424cb6fcb537d81fe7bd94181cf1a.
    [ar.h, common.h, eof.h, error.c]
